mmerttccolakk/akilli-rgb-led-denetleyici-terminal/c#-bilgisayar/AkilliAmbiyansRGBLED/AkilliAmbiyansRGBLED/Resources/ambilight-capture-screen-edge-colour.jpg

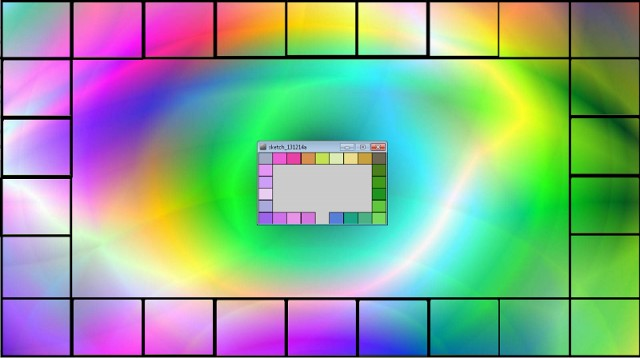
c#-bilgisayar/AkilliAmbiyansRGBLED/AkilliAmbiyansRGBLED/Resources/ambilight-capture-screen-edge-colour.jpg
