mmerttccolakk/akilli-rgb-led-denetleyici-terminal/README.md

# akilli-rgb-led-denetleyici-terminal
Hem yazılımsal hem donanımsal bir projedir. Ws218b ledleri chipten kontrol edilir. Bilgisayar yazılımı sayesinde çeşitli modlar ile kullanılabilir. Sabit renk seçme, ses analizi ile müzik şiddetine göre renklendirme, görüntü işleme ile ambiyans yaratma, polis, itfaye, flash, alarm gibi çeşitli modlar vb.
