mmerttccolakk/akilli-rgb-led-denetleyici-terminal/bitirme-proje.pdf

T.C.

## KARABÜK ÜNİVERSİTESİ

## MÜHENDİSLİK FAKÜLTESİ

## MEKATRONİK MÜHENDİSLİĞİ

## AKILLI ORTAM DENETLEYİCİ RGB LED

## TERMİNAL

# BİTİRME TEZİ

Hazırlayan

MERT ÇOLAK | 2015110226006

Tez Danışmanı

Yrd.Doç.Dr. İbrahim ÇAYIROĞLU

KARABÜK-2019

İÇİNDEKİLER

Sayfa
İÇİNDEKİLER | 1
ÖNSÖZ | 3
ÖZET | 4
TABLOLAR VE ŞEKİLLER | 5
KISALTMALAR | 6
BÖLÜM 1 | 7
GİRİŞ | 7
1.1. GİRİŞ | 7
1.2. AMAÇ | 7
1.3. KULLANIM ALANI | 7
BÖLÜM 2 | 8
ELEKTRONİK KART TASARIMI, ÜRETİLMESİ VE PROGRAMLANMASI | 8
2.1. KULLANILAN ENTEGRELER VE KOMPANENTLER | 8
2.1.1. ATMEGA328P-AU MİKRODENETLEYİCİ | 8
2.1.2. CH340G (USB_TTL) | 9
2.2. KART ÜRETİMİ | 9
2.2.1. ŞEMA ÇİZİMİ | 10
2.2.2. BASKI ÇİZİMİ | 11
2.2.3. BASKI DEVRE YAPMA | 11
2.3. ELEKTRONİK KARTIN PROGRAMLANMASI | 102
2.3.1. BOOTLOADER YÜKLENMESİ | 13
2.3.2. PROGRAMIN YÜKLENMESİ | 13
2.3.3. ELEKTRONİK KARTIN İLETİŞİM PROTOKOLÜ | 14
2.3.4. ELEKTRONİK KARTIN PROGRAMI | 15

### ÖNSÖZ

Öncelikle, projeme görüşleriyle yön veren ve desteğini hiç esirgemeyen, Yrd. Doç.Dr.

İbrahim ÇAYIROĞLU hocama ve lisans eğitimim boyunca bizden desteklerini

esirgemeyen bölüm hocalarıma teşekkür ederim. Tüm eğitim öğretim hayatım boyunca

benden maddi ve manevi desteklerini eksik etmeyen aileme sonsuz teşekkürlerimi sunarım.

MERT ÇOLAK

ÖZET

Yaptığım bu projede akıllı ortam denetleyici rgb led terminal yapacağım. Genel amaç oyun

ve film sektöründeki görselliği arttırmada kullanılan ambiyans aydınlatmalarla ilişkili.

Proje de tasarlanan kart ve yazılım sayesinde bilgisayardaki görüntüyü analiz ederek

monitörün arkasını aydınlatır. Bu bir monitörde olabilir, bir sinema sahnesi de. Böylelikle

ekrandaki oyunu, filmi ledlerle ekrandan, dışarı taşıyan kendinizi daha etkin bir şekilde

oyunun, filmin içindeymiş gibi hissetmenizi sağlayan bir aydınlatma uygulamasıdır. Sadece akıllı ambiyans yaratmayacak. Farklı modlarda eklenmiştir. Örnek vermek

gerekirse yazılımsal ses analizi. Yazılımsal ses analizi sayesinde bilgisayara ek bir

donanım takılmadan ses yazılımsal olarak analiz edilecek, kullanıcı müziği kulaklıkla dahi

dinlese analiz edilerek müziğin şiddetine göre tepki verir. Diğer modlardan bahsedecek

olursam flash, polis, ambulans, itfaiye, sabit renk gibi efektler eklenmiştir. uyku modu gibi

değişik modlarda eklenmiştir. Mesela 120 dakikaya programı kurduğunuzda istediğinize

göre 120 dakika sonunda tamamen kapanabilir veya 120 dakika dolmaya başladıkça yavaş

yavaş söner ve kapanır.

TABLOLAR VE ŞEKİLLER

Sayfa

Tablo 2: Arduino Uno ile bootloader yüklenirken bağlanması gereken pin bağlantıları... 13

KISALTMALAR

Volt | V
Amper | A
Red Green Blue | RGB
Universal Serial Bus | USB
Light Emitting Diode | LED
Transistor To Transistor Logic | TTL
Basic Input/Output System | BIOS
Alf Ve Vegard RISC | AVR
Pulse Width Modulation | PWM
Bıt Per Second | BPS
Frame Per Second | FPS

BÖLÜM 1

### 1.1. Giriş

Akıllı ambiyans aydınlatma, bulunduğu çevreyi veya ortamı o anki ses, müzik veya

görüntü analizi yaparak ortamı aydınlatır. Ortama göre aydınlatma yapılarak ışığın tonu,

rengi ve aydınlatma miktarı ayarlanabilir. Loş bir ortam veya aydınlık bir ortam seçilebilir.

Böylelikle ortam ambiyansını hissetmeyi güçlendirir. Bir su sahnesinde veya bir alev

sahnesinde ortam sahneye göre aydınlandığında sanki filmin içindeymişiz gibi

hissetmemizi sağlar.

### 1.2. Amaç

Bir akıllı ortam denetleyici rgb led terminal tasarlamak ve yazılımıyla birlikte tüm

bilgisayarla uyumlu çalışan bir yazılım yazarak akıllı ortam denetleyici projesi oluşturmak.

Böylelikle her bilgisayara kolayca takılabilen çevresel bir donanım aksesuarı

oluşturmaktır. Proje tasarlanırken seri üretim düşünülerek elektronik kart tasarlanmış ve

yazılımın uyumluluğu düşünülmüştür. Buna göre her bilgisayarda bulunan haberleşme için

USB kullanılmış. Yazılım ise C# ta yazılarak, çeşitli performans geliştirmeleri yapılarak

çekirdek için özel olarak performans seçenekleri eklenmiş ve kurulabilir şekilde

derlenmiştir. Böylece her kullanıcı bilgisayarı için istediği performansı seçerek rahatça

kullanabilmektedir.

### 1.3. Kullanım Alanı

Sinema, konferans, gösterimler, oyuncu etkinlikleri gibi görüntü odaklı veya müzik odaklı,

konser, parti gibi aydınlatma sağlanan her yerde kullanılabilir. Proje ambiyans yaratmak

istenen her yer de kullanılabilir. Ve farklı modlar eklendiği için mesela uyku modu,

karanlıktan korkan çocuklar için bile kullanılabilir. Belirli bir dakika sonunda aydınlatma

kesilir veya istenildiği takdir de seçeneklerden yavaş yavaş karartma seçilebilir. Onun

dışında acil bir durum için polis, itfaiye, ambulans gibi çeşitli modlar kullanılabilir.

Kısacası bir çevresel donanım olarak bilgisayara takılabileceği gibi bir gösteride akıllı

ortam aydınlatması için de kullanılabilir.

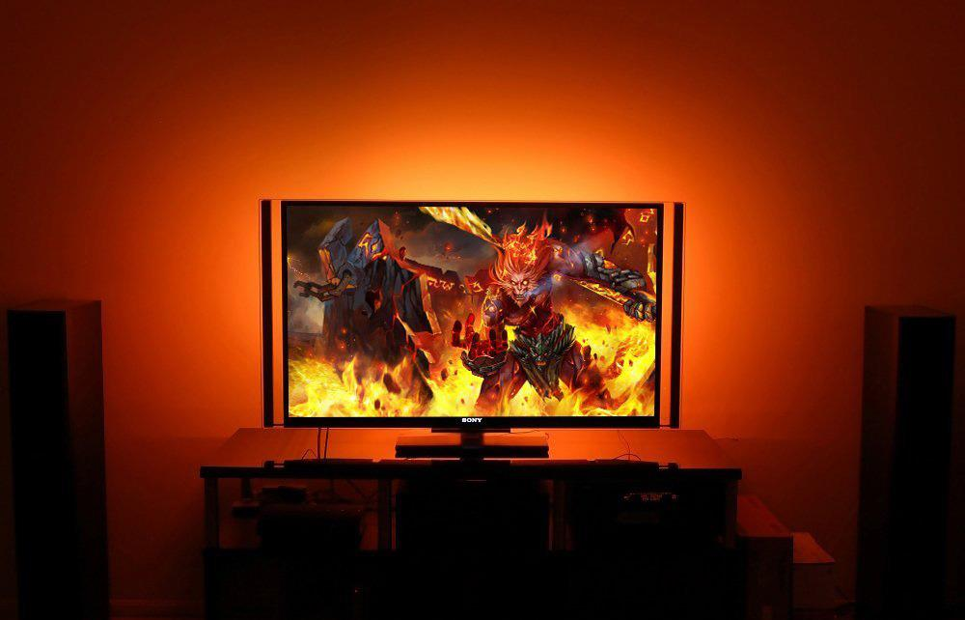
[picture p2: figure]

Şekil 1: Akıllı ortam denetleyici rgb LED terminal ile aydınlatılmış bir sahne

BÖLÜM 2

### 2.1. Kullanılan Entegreler Ve Kompanentler

Kart tasarımında iki ana entegre bulunmaktadır. Bunlardan biri “atmega328p-au” mikro

denetleyicisi. Diğeri ise “CH340G” entegresidir. Diğer kompanentler ise güç girişi için

adaptör jak’ı, voltaj regülesi için regülatör, kısa devre ve güç dalgamanlasını önlemek için

diyot ve kondansatörler bulunmaktadır.

### 2.1.1. Atmega328p-Au Mikro Denetleyici

Projenin kart üzerinde çalışan sistemin ana bölümüdür. “CH340G” gelen seri bilgileri işler

ve programlanabilir olan “WS2812B” ledlerin konumunu belirler ve ona göre parlaklık,

renk gibi verileri gönderir. Bu mikro denetleyici ürünü TQFP-32 kılıfta olup SMD yapısına

sahip olduğu için dip kılıflara göre az yer kaplar. 20 MHz frekansı ile çalışan 8 bit değerinde mikro denetleyici çeşitlerindendir. Üzerinde bulunan 32 pinin 23 adedi I/O yani

Giriş Çıkış pinidir. Bellek tipi FLASH olan bu mikro denetleyiciler 5.5V ile 1.8V besleme

aralığında, -40 C° ile +85 C° sıcaklıkları aralığında çalışabilmektedir.

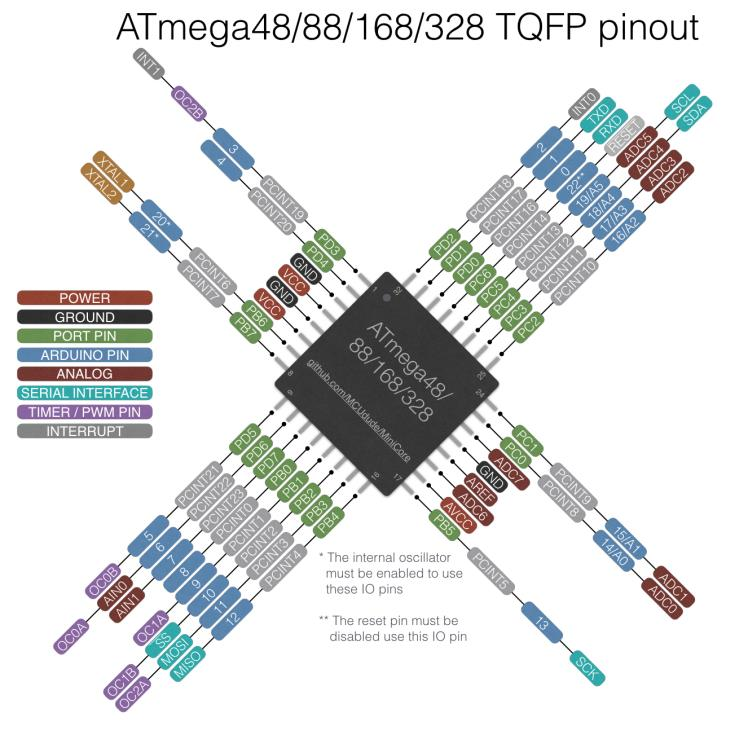
[picture p3: figure]

Şekil 2: Atmega328p-au pin yapısı

### 2.1.2. CH340G (USB_TTL)

Mikro denetleyicilerin birçoğu direk olarak USB protokolünü desteklemez. Bu entegre

yardımıyla USB protokolü ile bilgisayara bağlanarak, seri port çıkışı sağlarız. Böylelikle

seri porttan aldığımız bilgileri mikro denetleyiciye gönderebilir veya programlayabiliriz.

### 2.2. Kart Üretimi

Kart üretiminde, devremizi önce şema halinde çizeceğiz ardından baskı için baskı devresini

çizip en son da kart basımından sonra bootloader yükleyip, programlayacağız.

### 2.2.1. Şema Çizimi

Şema çizimini yaparken mikro denetleyicinin ve kullanacağım seri port entegresinin

datasheet’ini kullanacağım. Daha önceden kullandığım kart tasarlarımdan da örnek alarak

şemayı parça parça modül olarak tasarlayacağım. Böylelikle ilk devremizi test ederken tek bir kart tasarlamak yerine, iki ayrı modülle test edebileceğiz. Örnek olarak 2 kart

tasarlanacak ve bir sorun olursa tüm entegreler tüm çizimler yeniden çizilmeyecektir. En

son devreler sorunsuz çalışır ise tek bir kart tasarlanarak tekrar basılacaktır. Buradaki amaç

aslında versiyon geliştirmek içinde kullanılabilmektedir. USB-TTL modülü sabitse diğer

versiyonda mikro denetleyici değişirse prototipini test etmek hem daha ekonomik hem de

daha hızlı olacaktır. Buradaki tasarladığım devrede bir sorun çıkmadı. Usb-ttl ve mikro

denetleyici olarak tasarladığım iki modülde düzgün çalıştı. Böylelikle tek bir kart tasarımı

yaparak projeyi bitirdim.

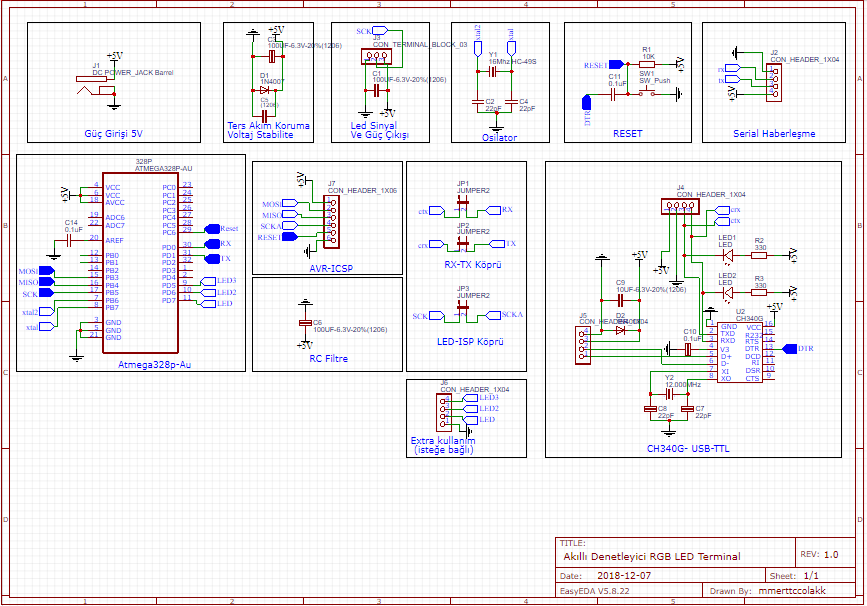
[picture p4: figure]

Şekil 3: Şema Tasarımı

### 2.2.2 Baskı Çizimi

Şemasını çizdiğimiz elektronik kartın, baskı devresi için devre yollarını çizdim bu

bölümde. Burada dikkat edilmesi gereken nokta dip ve smd elemanlarını yerleştirirken

yüzlere dikkat edilmesidir. Dip kompanentler olduğu zaman kartın diğer yüzünde olduğu

için entegreler simetri edilerek karta çizilir. Bir diğer noktada elemanların güç analizini

yaparak mesela devremizde olan güç çekecek olan “şerit programlanabilir ws218b ledleri”

gibi elemanların devre yollarını kalın tasarlamaktır.

Link 1: Elektronik Kart Şeması Ve Baskı Devresi

“https://easyeda.com/mmerttccolakk/Amblight-Project”

Bağlantı Yolu Genişliği | Taşınabilecek Maksimum Akım Değeri
0,2 mm | 100 mA
0,5 mm | 300 mA
1,0 mm | 2,5 A
2,0 mm | 5 A
3,0 mm | 6 A
4,0 mm | 7 A
5,0 mm | 9 A

Tablo 1: Baskı devre yolları tasarlanırken standart bir bakır plaka için kompanentlerin ve

elemanların çekebileceği amper göz önüne alınarak devre yolunun genişliğine dikkat

edilir.

### 2.2.2 Baskı Devre Yapma

Baskı devre yapmak için birçok yöntem vardır. Seri üretim için cnc veya lazerli bakır yol

çiziciler vb. Ben baskı devreyi yaparken ütü baskı yöntemini kullandım. Baskı devreyi çizdiğim baskıyı aynalayarak pdf’i lazerli yazıcıyla kuşe kâğıdına çıktı aldım.

Aynalamamın sebebi kâğıttan bakır yüzeye geçtiğinde çıktının simetrisi olmaktadır.

Burada yazıcının tonerli olması önemli çünkü toner sıcaklıkla transfer olabilen bir madde.

Ve biz bu maddeyi ütülerek baskı devreye geçiriyoruz. Bakır levhayı temizledikten sonra

ütünün en sıcak ayarında çıktı aldığımız kâğıdı 10 dakika ütülüyoruz. Baskı devre, bakır

plakaya çıktıktan sonra. Bakır levha üzerindeki kâğıdı su ile yavaşça temizliyoruz, sadece

toner kalacak şekilde. Daha sonra %20 Pehidrol, %80 Tuz Ruhu karışımına atarak bakır

levhanın tonerli olmayan kısımlarının erimesini bekliyoruz. Yaklaşık 5 dakika sürüyor.

Böylelikle devre yollarımız çıkmış oldu. Ardından pin deliklerini delerek, kompanentleri

yerleştirip lehimliyoruz.

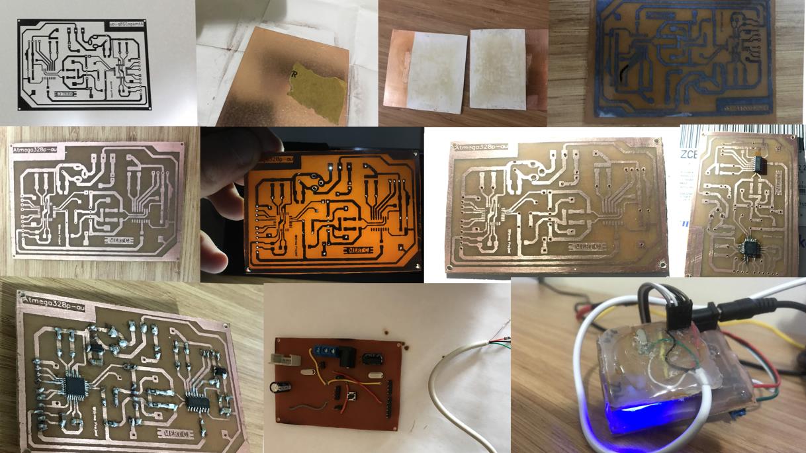
[picture p5: figure]

Şekil 4: Baskı Devre Yapma

### 2.3. ELEKTRONİK KARTIN PROGRAMLANMASI

Öncelikle kullandığımız mikro denetleyici (atmega328p-au) ATMEL altyapısında olduğu

için ilk çalıştırma için bootloader gereklidir. İlk çalıştırma için bu zorunlu bir işlemdir.

Bootloader işlemi tıpkı bilgisayarların BIOS’u gibi düşünülebilir. Mikro denetleyicinin

temel fonksiyonlarını yerine getirmesi için gereklidir. Bootloader işlemi ISP protokolü ile

başka bir ATMEL mikro denetleyici veya bir AVR programlayıcısıyla gerçekleştirilebilir.

Ben | bir | arduino | kullanarak | bu | işlemi | gerçekleştirdim. | Bootloader | işlemini

gerçekleştirdikten sonra artık ttl seviye ile devremizde bulunan “CH340G” entegremiz

sayesinde bir daha programlayıcı gerekmeden devre kendisini USB protokolünü kullanarak

programlayabilecektir.

### 2.3.1. BOOTLOADER YÜKLENMESİ

Öncelikle arduino veya avr bağlantımızı şekil 5 te verilen şekilde ISP pin ve güç

bağlantılarını yaptıktan sonra Arduino Programını IDE sini açıyoruz.

- Dosya > Uygulamalar > ArduinoISP seçip.
- Araçlar > Board > Arduino Uno
- Araçlar > Serial Port (Burdan hangi Com portundaysanız onu seçin)
- Araçlar > Programlayıcı > AVRISP mkII seçiniz.
- Araçlar > Önyükleyiciyi yazdır.

Böylelikle Bootloader işlemini tamamlamış olduk.

ARDUİNO UNO | MİKRODENETLEYİCİ
5V | VCC
GND | GND
10 | RESET
11 | MOSI
12 | MISO
13 | SCK

Tablo 2: Arduino Uno ile bootloader yüklenirken bağlanması gereken pin bağlantıları

### 2.3.2. PROGRAMIN YÜKLENMESİ

Kartımıza daha önceden yerleştirdiğimiz dahili olan “CH340G” entegresi olduğundan

dolayı kartımıza Arduino IDE’yi açarak kolayca arduino uno programlıyormuş gibi

programlayabiliriz. Kartımızı USB ile bilgisayarımıza taktığımızda “CH340G” entegresi

RX-TX bağlantıları ile atmega328p-au ile veri transferi yaparken DTR-RESET bağlantısı

ile de otomatik yazılım yükleme moduna almaktadır. Yazdığımız kodu kartımıza atmak için programımızı açtıktan sonra, Araçlar > Kart menüsünden Arduino UNO seçeneğini

tıklıyoruz. Daha sonra, yine Araçlar menüsünden Port alt menüsü altında kartımızın bağlı

olduğu portu seçiyoruz. Bu port numarası, her bilgisayarda farklı olabilmektedir.

Programımızı yazdıktan sonra kartımıza yüklemek istediğimizde, öncelikle “Kontrol Et”

seçeneğine tıklıyoruz. Program, yazdığımız kodu öncelikle bilgisayarımızda bir klasöre

kaydetmemizi istiyor, daha sonra da yazdığımız kodu derleyerek herhangi bir hata varsa bu

hatayı bize bildiriyor. Eğer yazdığımız kodda bir hata yoksa ve kartımız bilgisayarımıza

USB ile bağlıysa, “Yükle” seçeceğine tıklayarak kodumuzu kartımıza yükleyebiliyoruz.

### 2.3.3. ELEKTRONİK KARTIN İLETİŞİM PROTOKOLÜ

Elektronik kartın iletişimi “CH340G” entegresi ile bilgisayardan usb bağlantısıyla seri port

açıp atmega328p-au bağlanmasıyla gerçekleşir. Elektronik kartın programı yazılırken veri

iletişim performansını ve yazılımın stabilitesini arttırmak amacıyla değişkenler minumum

seviyede kullanılmış. Ve üst değer limitleri fazla olan int long vs değişkenleri mümkün

olduğu yerlerde byte ve sabit değer yapısıyla tasarlanmıştır. Int ile 0-255 saydırmakla byte

yapısında 0-255 saydırmak arasında performans açısından büyük bir fark bulunmaktadır. 1

Byte = 8 Bit değerindedir. Kısaca programın iletişim protokolünden bahsedecek olursam.

60 Led’imiz varsa her biri için 3 byte gereklidir. Her byte led’in bir rengi için bir PWM

değerini temsil etmektedir. Bir led’te tüm renkleri oluşturabilmek adına 3 ana renk

bulunur. Bunlar kırmızı, yeşil ve mavidir. Bunlara ayrı, ayrı vereceğimiz pwm sinyali

sayesinde bir led’te 0-255^3 ten 16581375 farklı renk elde edilebilmektedir. Ledlerin

konumu için ise farklı bir protokol geliştirerek konum bilgisi göndermedim. Eğer konum

bilgisini de göndersemdim 3 byte yerine her seferinde 4 byte gönderecektim ve buda %25

performans kaybı demektir. Bilgisayar programında kaç adet led’imiz olduğunu kurulum

sırasında bir kez söylüyoruz. Ve daha sonra her iki program her 3 byte da bir diğer led için

bilgileri almaya başlıyor. Bu döngü her led için tekrarlandıktan sonra program başa

dönüyor. Böylece 3 byte ile hem konum hem de renk bilgisi sağlanabiliyor. Programımız

115200 BPS de iletişim kuruyor. Saniyede 115200 bit transfer ediliyor.

Bir saniyede tüm led’lerin güncellenme sayısı:

60 led’imiz olduğuna göre 60*3 RGB için 180 byte

60*3*8 byte >> bit çevrimi 1440 bit
İletişim protokolümüz bant genişliği 155200 bps

Saniye tüm ledlerin güncellenme sayısı 115200/1440=80 rps

Kısaca iletişim protokolümüz 60 tane rgb led’i konumuna ve rengine göre saniyede 80 defa

güncelleyebiliyor.

### 2.3.4. ELEKTRONİK KARTIN PROGRAMI

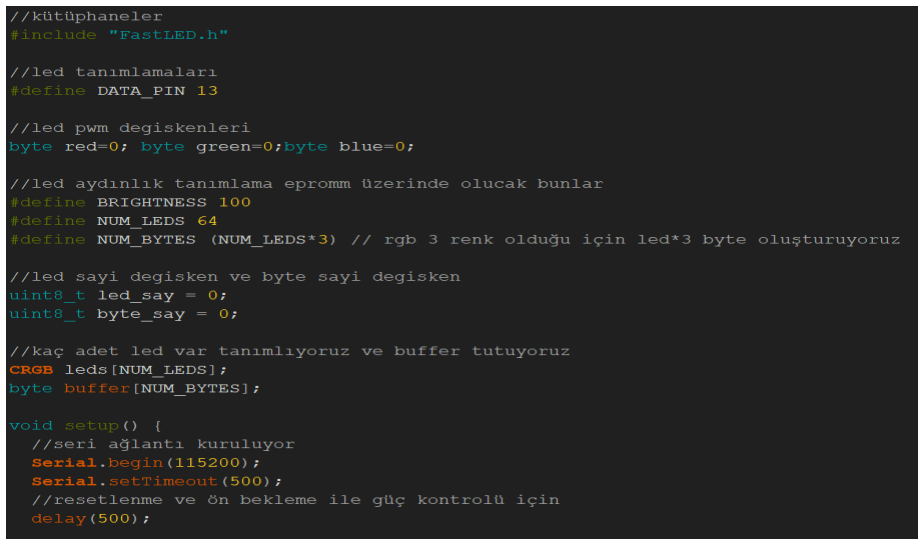
[picture p6: figure]

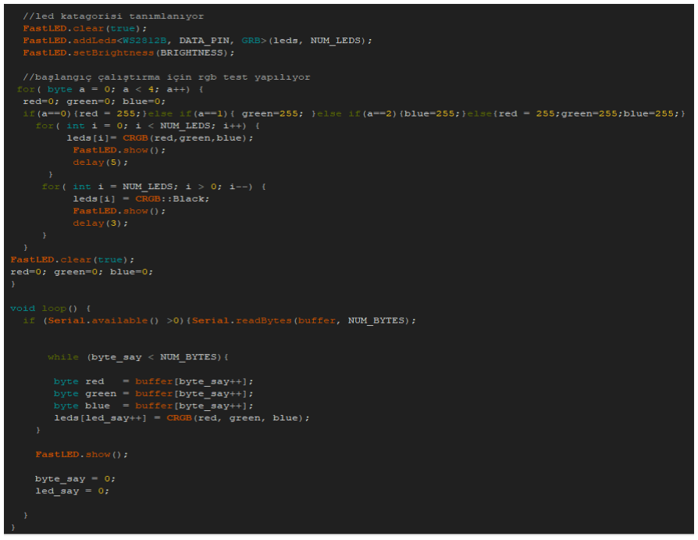
[picture p7: figure]

Şekil 5: Elektronik Kartın Program Kodları

BÖLÜM 3

### 3.1. LCD ÇERÇEVE YAPIMI

LCD çerçeve yaparken, tasarlayacağımız çerçeve programlanabilir olan WS218B şerit

ledlerden yapılmıştır. Kolaylıkla çerçevenin her bilgisayarın monitörüne, televizyona,

sinema sahnesi vs uyumlu olması için modüler yapılmıştır. Ekleme aparatlarıyla sadece

ledleri keserek araya 90 derece konektörler atılır.

### 3.1.1. LCD ÇERÇEVESİ MONTAJI

Ledler, ekranın ölçüsü alınarak yatayda ve dikeyde uygun boyda kesilir. Ardından 90

derecelik konektörler takılarak dikdörtgen biçimine getirilir. Burada dikkat edilmesi

gereken nokta ledlerin akış yönüdür. Ledler üzerindeki oklara göre birbirine bağlanmalıdır.

Çerçeve dizildikten sonra sıcak silikon ile bilgisayarın çerçevesine montajı yapılmıştır.

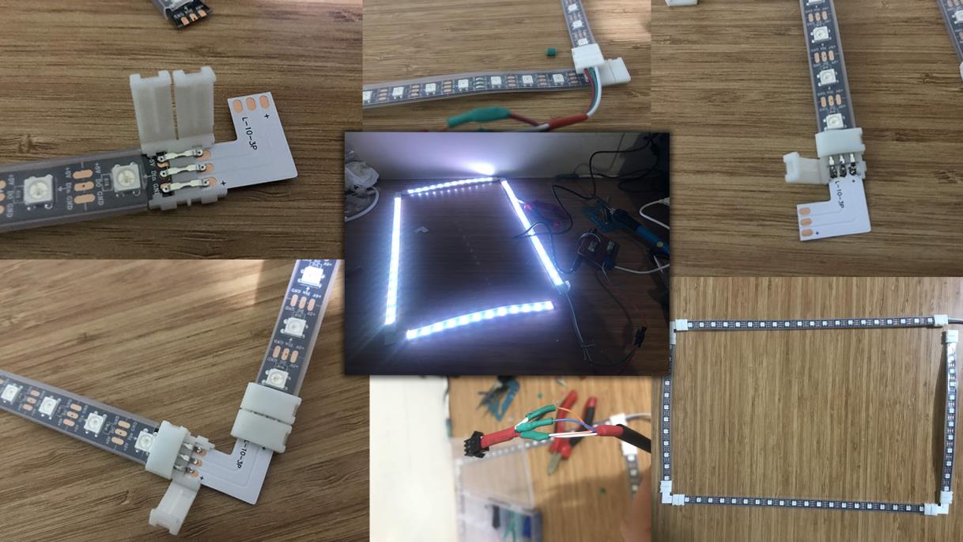
[picture p8: figure]

Şekil 6: LED çerçevenin yapımı

### 3.1.2. LED İÇİN JAK VE KABLO BAĞLANTISI

LCD çerçevesi tamamlandıktan sonra sıra LCD çerçevesinin elektronik karta

bağlanmasında, bilgisayara sürekli olarak takılmayacağını düşünürsek veya taşınabilir bir

bilgisayara takılabileceğini düşünürsek bu çerçeveye sabit bir kablo takmak doğru olmaz.

Konektör tarzında kablo ayıraçları ile kablolar takılmıştır. Bir konektör LCD çerçeveye

bağlanırken Bir çerçevede elektronik karta bağlanarak istenildiğinde bilgisayardan kart

sökülüp başka bir bilgisayara takılabilir. Ve taşıma aşamasında kolaylıkta sağlar. Kablo

konektörleri bağlanırken lehim kullanılarak zamanla oksitlenmesi engellendi daha sonra

kablolar makaronla sarılıp ısıtıldı ve iyice sağlamlaştırıldı.

BÖLÜM 4

### 4.1. BİLGİSAYAR PROGRAMI

Bilgisayar programı Visual Studio programında C# programlama dili kullanılarak

yazılmıştır. Kullanıcıların kolaylıkla kullanabilmesi için arayüz sadeleştirilmiş, ayarlar ve

hesaplamalar otomatikleştirilmiştir. Program ilk açıldığında led sayılarını bir kez girip

kaydet’e basmanız durumunda bir daha tekrar aynı ayarı yapmanıza gerek kalmamaktadır.

Program içerinde özel ayarları tutan bir veri tabanı eklenmiştir. Ayrıca her bilgisayarda

kolaylıkla çalışabilmesi için RAM ihtiyacını düşük tutan (using, thread, private value gibi)

fonksiyonlarla programlanmıştır. Programı ilk tasarladığımda saniyede iki kere görüntü

analizi yaparken fonksiyon kullanımlarını ve çeşitli performans ayarlarını öğrendiğimde bu

sayı saniyede dört yüz ’ün üzerine çıktı. RAM ise 1500MB tan 30MB düştü. Burada

belirtmek istediğim konu iki kodda aynı işi yaparken aradaki kod farkının ne derece önemli

olduğudur.

### 4.1.1. PROGRAMIN KURULMASI

Programın kurulması ve ayarlarının yapılması için ilk önce program açılır ve LCD

çerçevenin tek taraflı boyuna ve yatay ledleri sayılarak programın sol üstteki kısmına girilir

ve “Ayarları Kaydet” butonuna tıklanır ve program yeniden başlatılır. Daha sonra bağlantı

ayarları için elektronik kart bilgisayara takılır ve “Port” kısmından COM portu seçilerek bağlana tıklanır. Eğer bilgisayarda başka bir cihaz bağlı değilse zaten tek bir port

gözükecektir. Ama birden fazla cihaz takılıysa yanlış portu seçebilirsiniz. Eğer yanlış portu

seçmiş iseniz LCD çerçeve bir tepki vermeyecektir. “Bağlantıyı Kes” deyip bir diğer portu

seçin. Eğer doğru portu seçtiyseniz çerçeve kırmızı, yeşil, mavi ve beyaz olmak üzerine

hızlıca yanıp söner. Bunun bir diğer nedeni de rgb ledlerin sağlamlık testini yapmaktır.

Böylece kurulumda tamamlanmış olur. Bağlantı portunu değiştirmediğiniz sürece port

numarası sabit kalacaktır.

### 4.1.2. PROGRAMIN TANITILMASI

Program 4 ana bölümden oluşmaktadır. Bunlar aşağıdaki “Tablo 3”te gösterilmiştir.

Bölüm | Açıklama
İstatistik-Durum | FPS değeri vb. değerlerin istatistikleri
Led Ve Ekran Ayarları | LED sayısının girildiği ayarlar
Bağlantı Ayarları | Bağlantının sağlandığı bölüm
Modlar | Modların seçildiği ve ayarlandığı bölüm

Tablo 3: Programın Ana Bölümleri

- İstatistik-Durum

Bu bölümde programın LED’leri kaç kere güncellediği FPS değerinden görülebilir.

Programın içerisine bir saat eklenmiştir ve bu saat son bir saniyede LED’lerin kaç kere

güncellendiğini tutarak FPS değerini ölçmüş olur. Bir diğer değişkende kaç dakika

kaldığıdır.

- LED Ve Ekran Ayarları

Bu bölümde programa LCD çerçevedeki yatay ve dikey LED sayıları girilerek kaydedilir.

- Bağlantı Ayarları

Bu bölümde seri port bağlantısı sağlanır. Aynı zamanda ilerde kart güncellenirse diye

programa bant genişlik ayarı da konulmuştur. Buradaki bağlantı kontrolü aynı zamanda

try/catch yapısı kullanılarak tasarlanmıştır. Ve bir timer ile sürekli bağlantı kontrol edilir.

Port birden kapanır veya hata verirse programda herhangi bir donma, takılma olmaz.

Program otomatik portu kapatır ve başlangıçtaki port seçim ekranına otomatik döner.

- Modlar

Modlar kısmında tab sekmesi kullanılarak bir grup içerisine birçok mod eklenmiştir.

Bunlar aşağıdaki “Tablo 4” te gösterilmiştir.

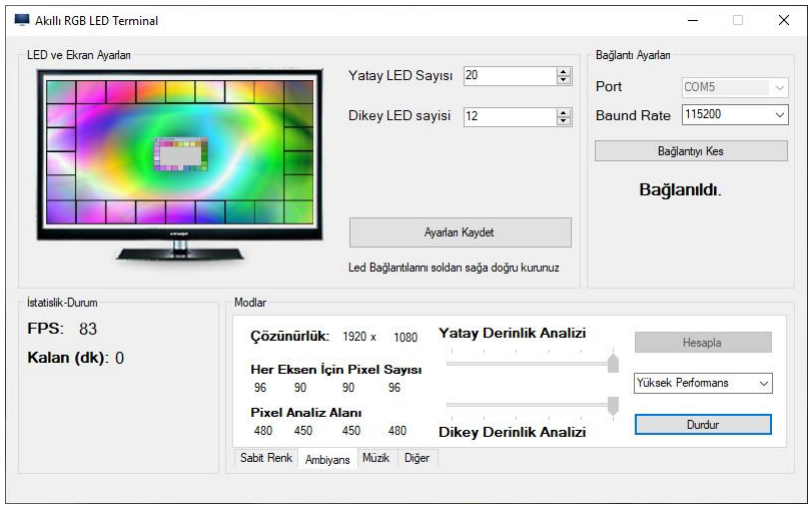
[picture p9: figure]

Şekil 7: Programdan bir görüntü

Sabit Renk Modu | Bu mod ’ta bir renk paletinden bir renk

seçilerek Tüm LED’lerin rengi değiştirilir.

Ambiyans MODU | Bu mod ‘ta yatay ve dikey analiz katsayısı

istenilirse arttırılır. Ve “Hesapla” butonuna

basarak | gerekli | hesapların | yapılması

sağlanır. Ardından istenilirse Performans

ayarı değiştirilir. Buradaki performans

ayarı, | çalışan | fonksiyona | | çekirdek

önceliğinin bir parametresidir. Yüksek

Performans, Normal, Düşük Performans

gibi parametreleri vardır. Artık “Çalıştır”

butonuna tıklayarak ambiyans modunu

aktif edebiliriz. Bu modu aktif ettiğimizde

ekrandaki görüntüyü analiz edip ona göre

dış çerçeveyi aydınlatacaktır.

Müzik Modu | Bu mod ‘ta programda öncelikle müzik

modunda hangi çıkış veya giriş cihazının

referans alınacağı aygıt listesinden seçilir.

Bu bir mikrofon veya hoparlörde olabilir.

Daha sonra istenirse trackbar dan ne kadar

yükseltileceği seçilir. Ardından performans

ayarları istenirse seçilir. Ve en son müzik

modunun | hangi | ritimde | yansıtılacağı

seçilir. Burada farklı efektler vardır.

Mesela müziğin ritmine göre şerit ledlerin

şiddeti sıralı olarak kayar veya tamamen

müziğe göre renk şiddeti oluşturur.

Diğer Modlar | Bu bölümde bir çok efekt vardır. Mesela

uyku modu programı 120 dakikaya kurup

120 dakika sonunda tamamen kapanmasını

sağla biliriz. Veya 120 dakika boyunca

yavaşça sönmesini de seçebiliriz. Onun

dışında | acil | durumlar | ve | ortam

aydınlatması için polis, itfaiye, ambulans,

flash, sakinleştirici gibi çeşitli efektlerde

eklenmiştir.

Tablo 4: Program içerisinde yer alan Modların açıklaması

### 4.1.3. PROGRAM KODLARI

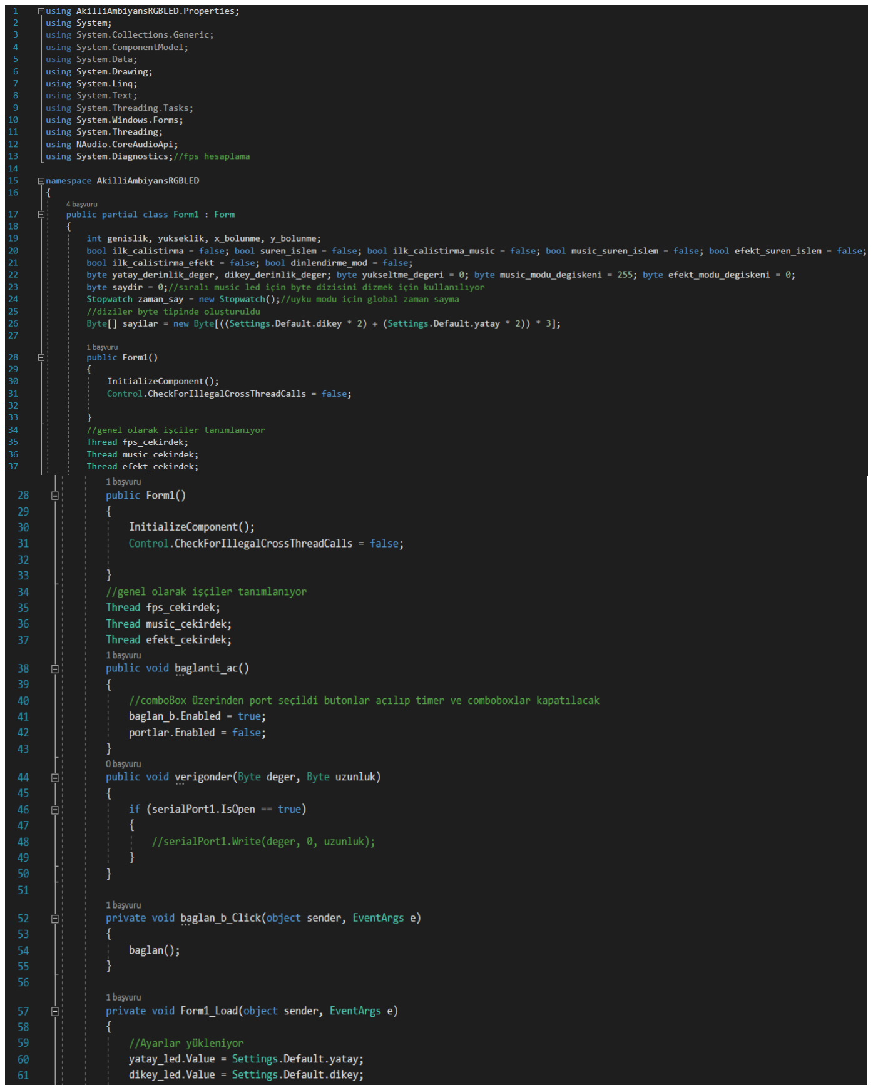
[picture p10: figure]

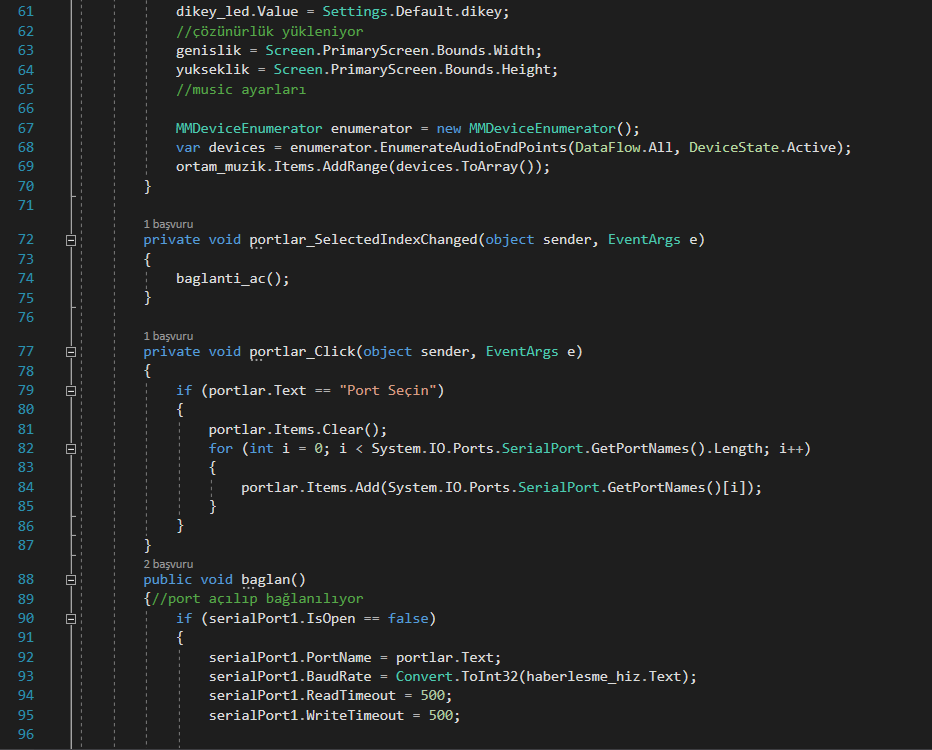
[picture p11: figure]

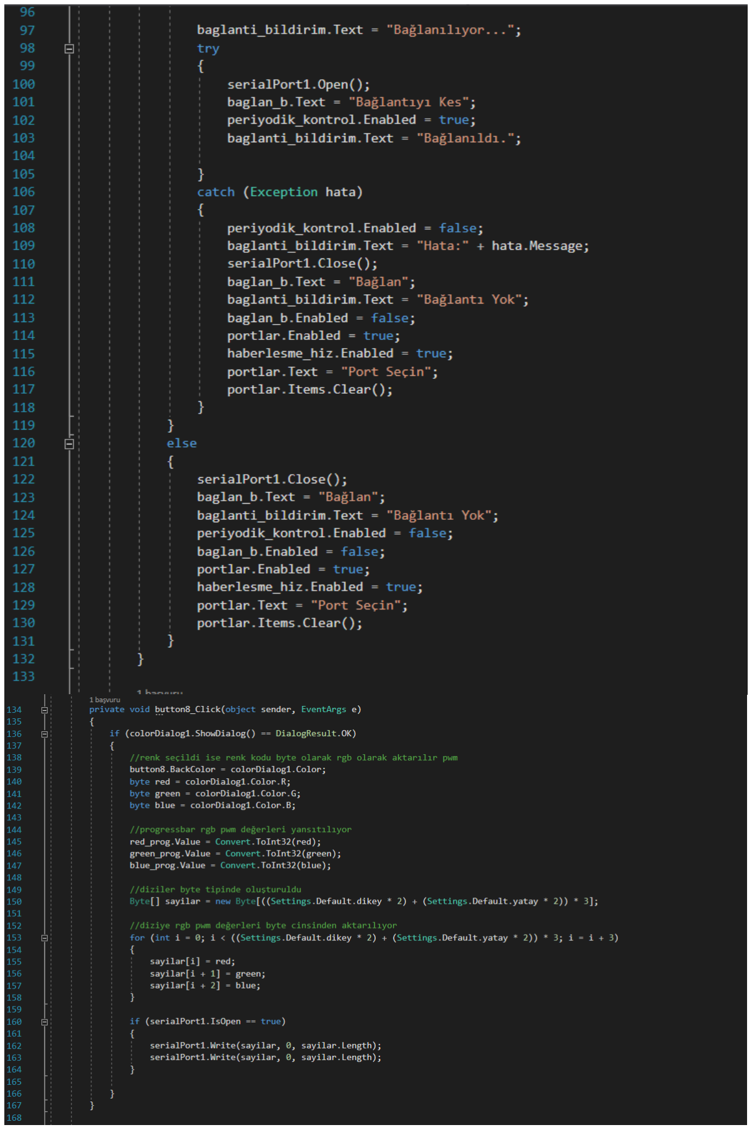
[picture p12: figure]
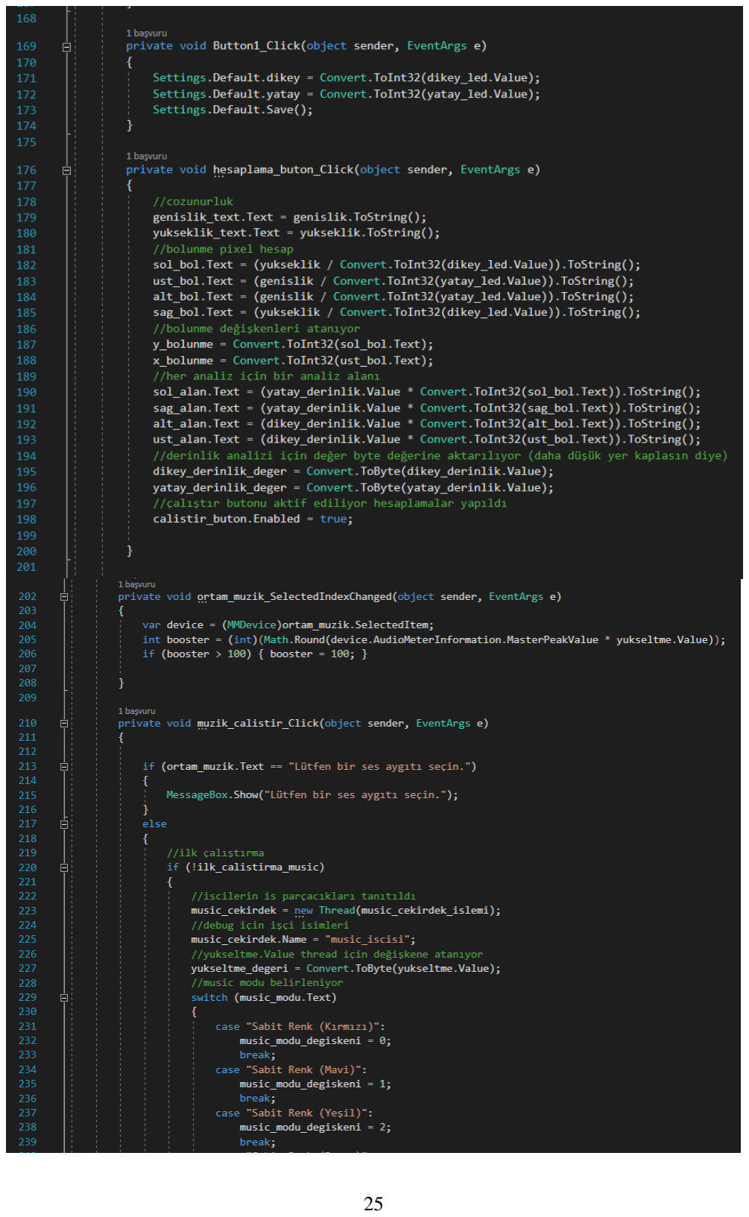
[picture p13: page 26]

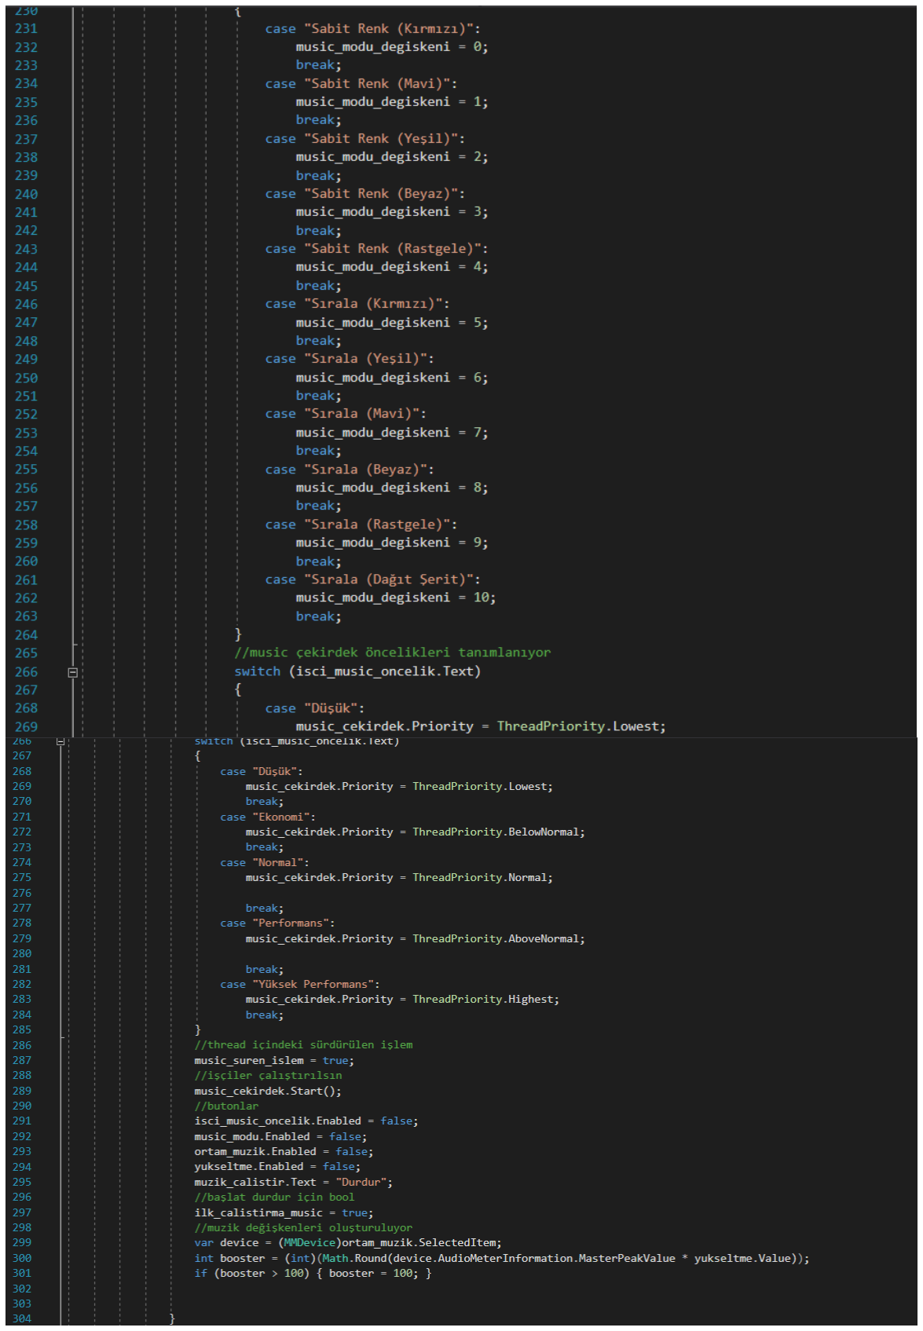
[picture p14: figure]

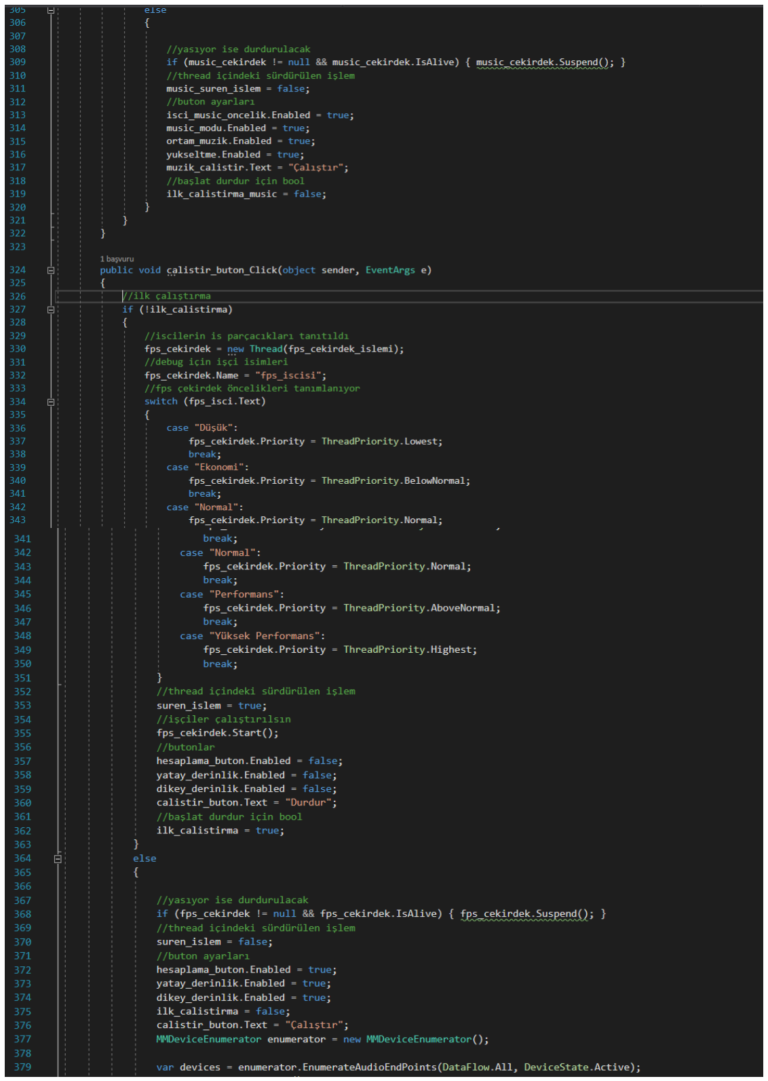
[picture p15: figure]

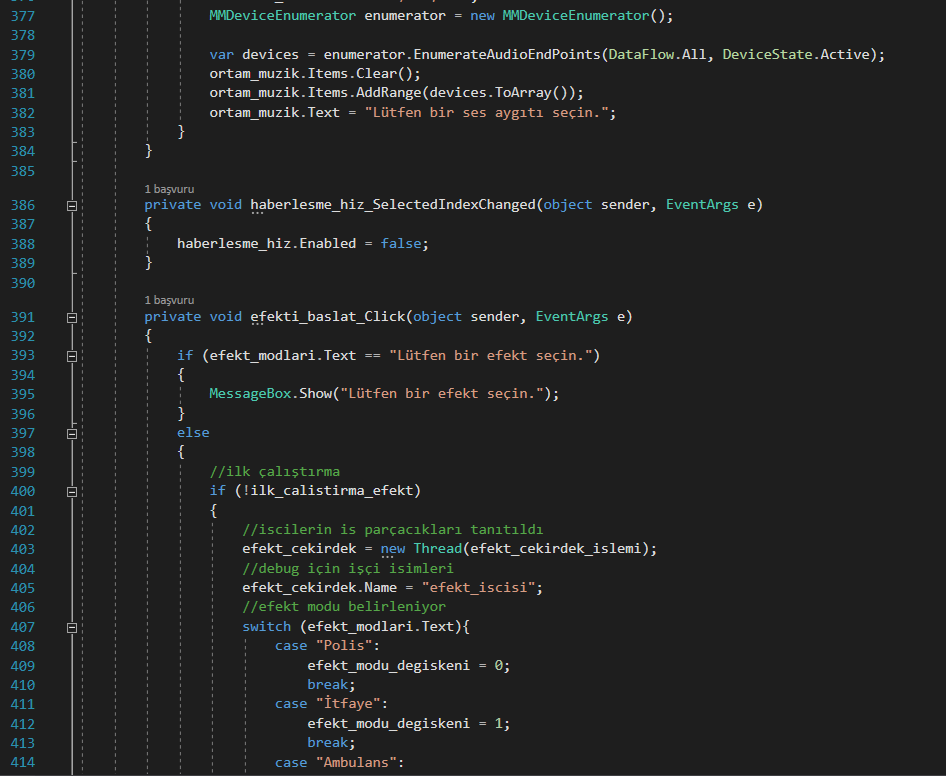
[picture p16: figure]

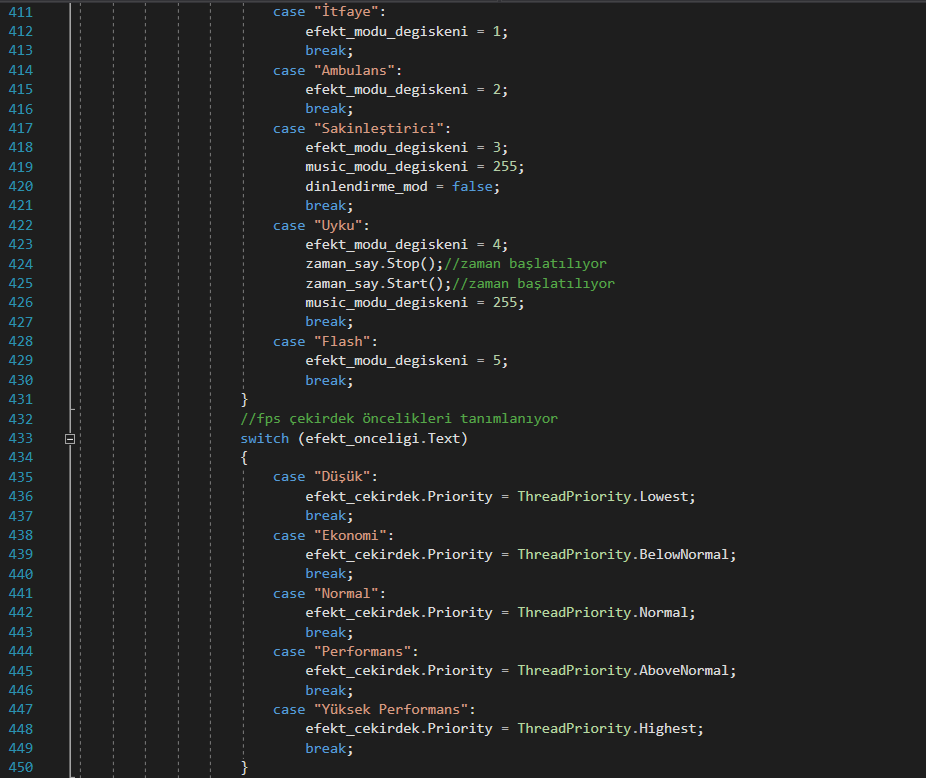
[picture p17: figure]

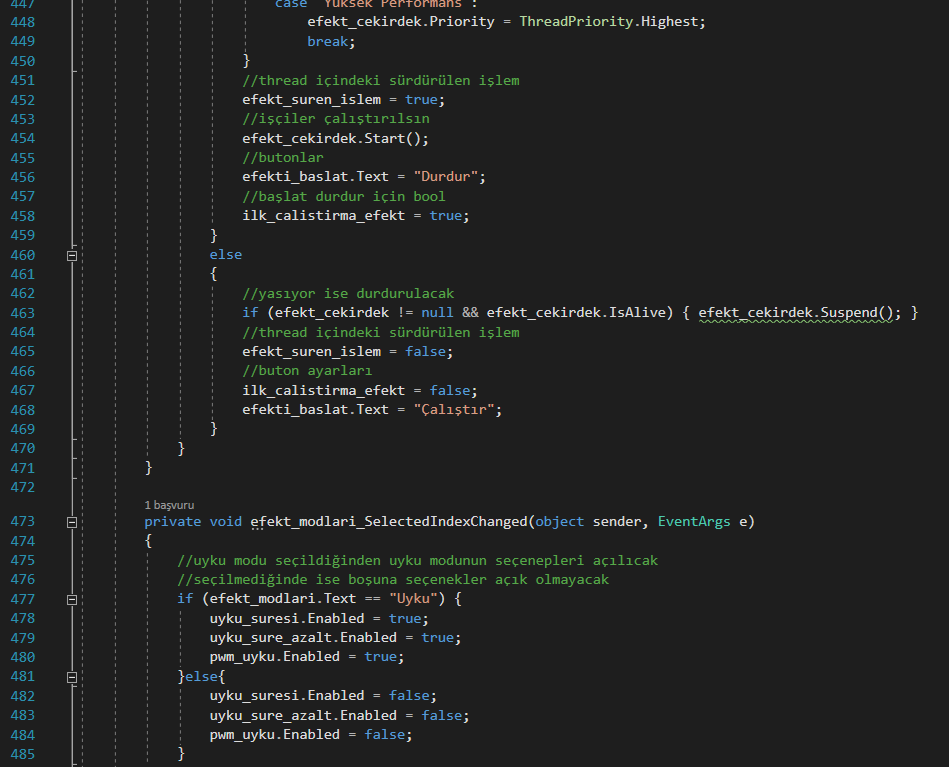
[picture p18: figure]

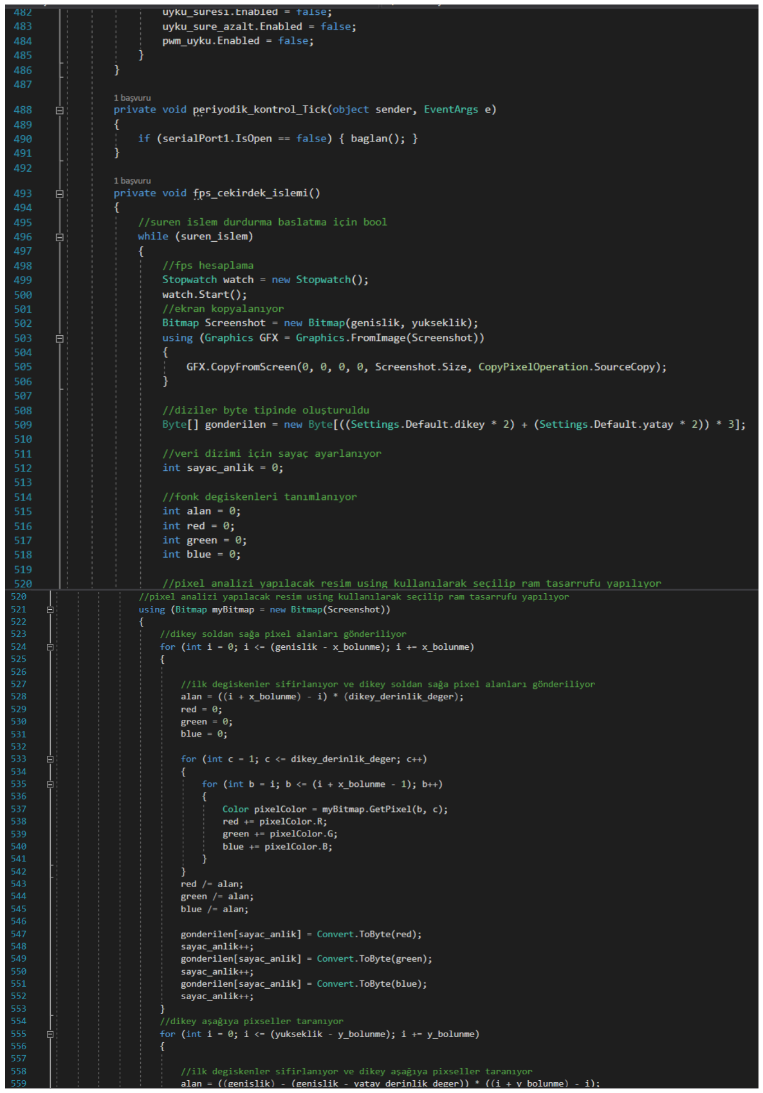
[picture p19: figure]

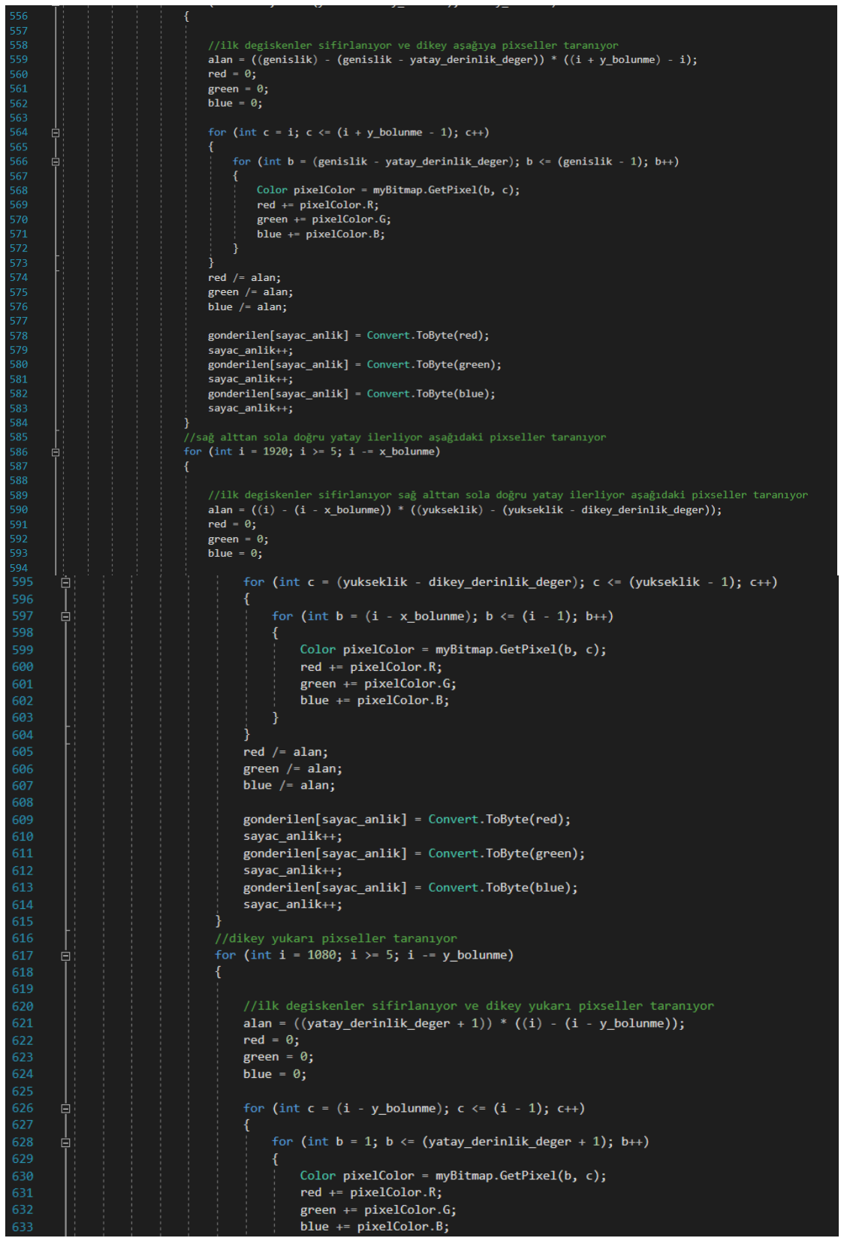
[picture p20: figure]

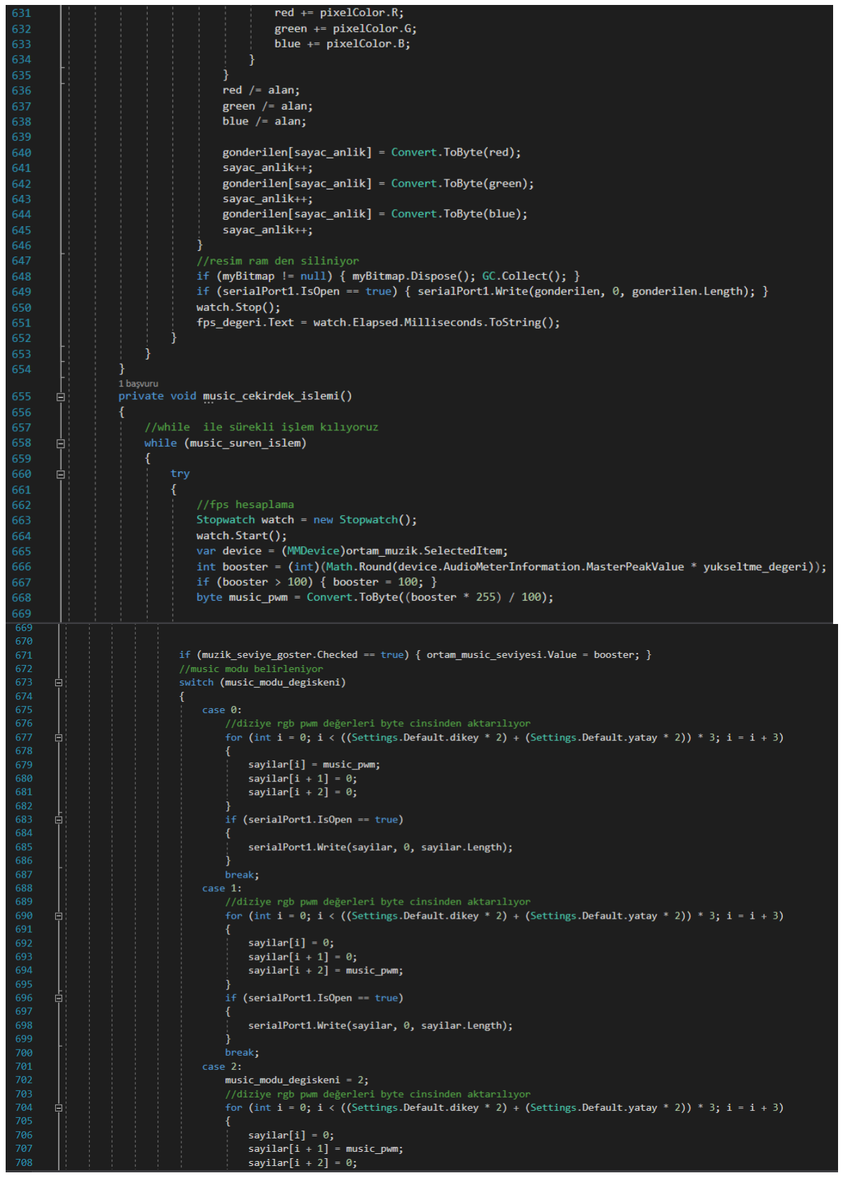
[picture p21: figure]

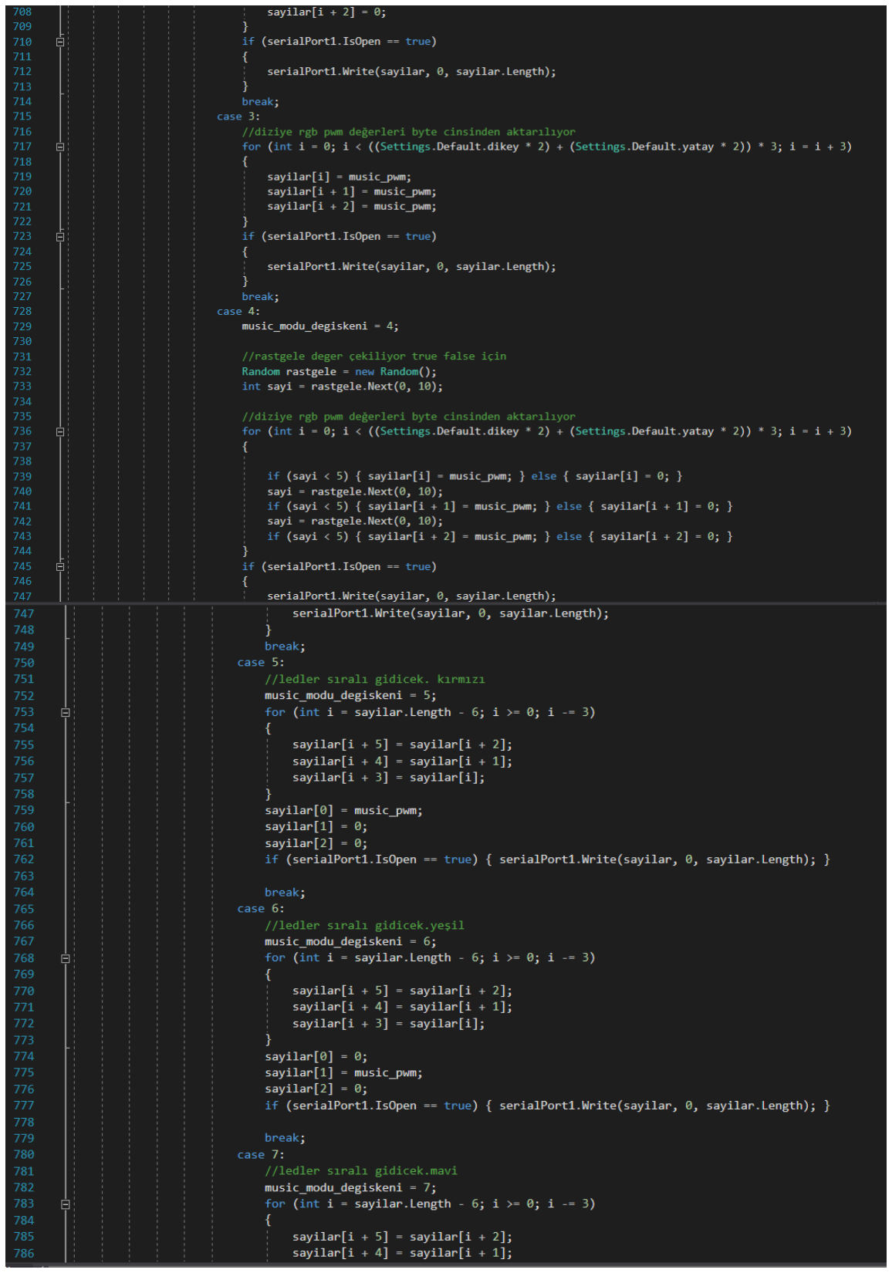
[picture p22: figure]

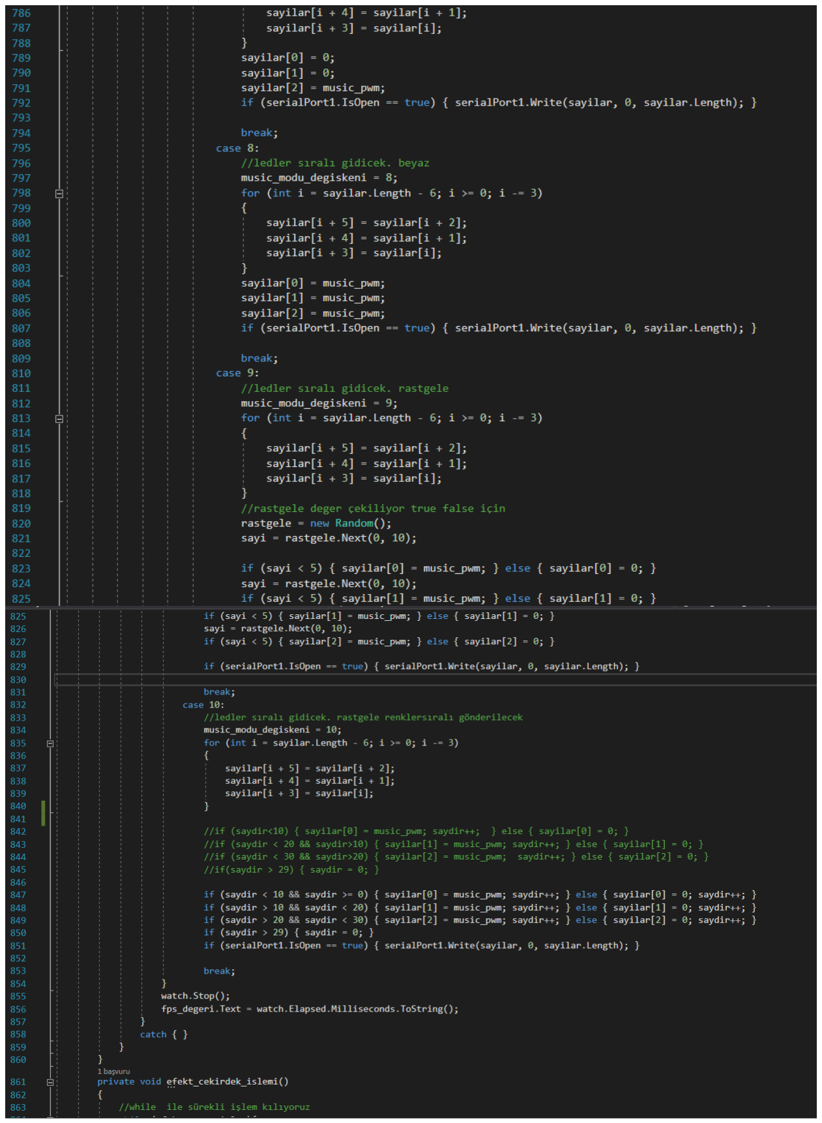
[picture p23: figure]

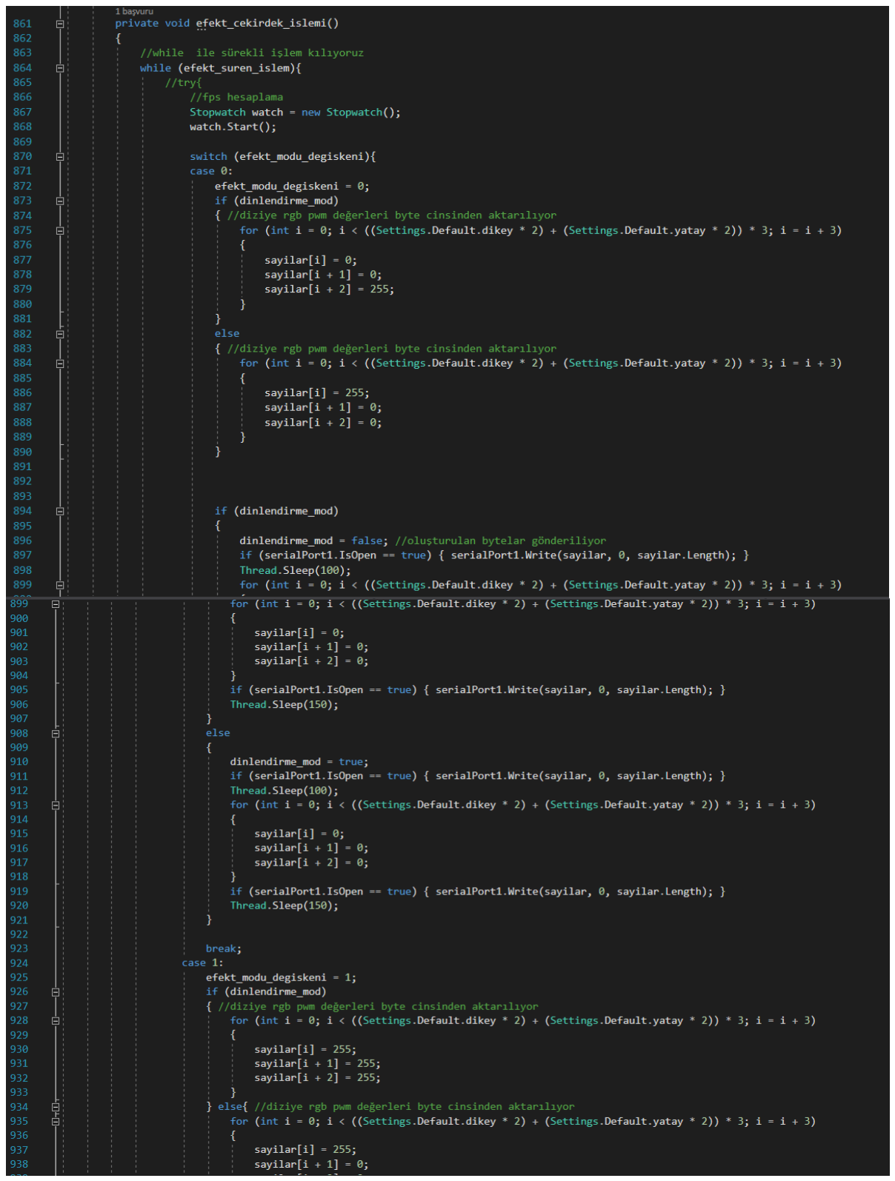
[picture p24: figure]

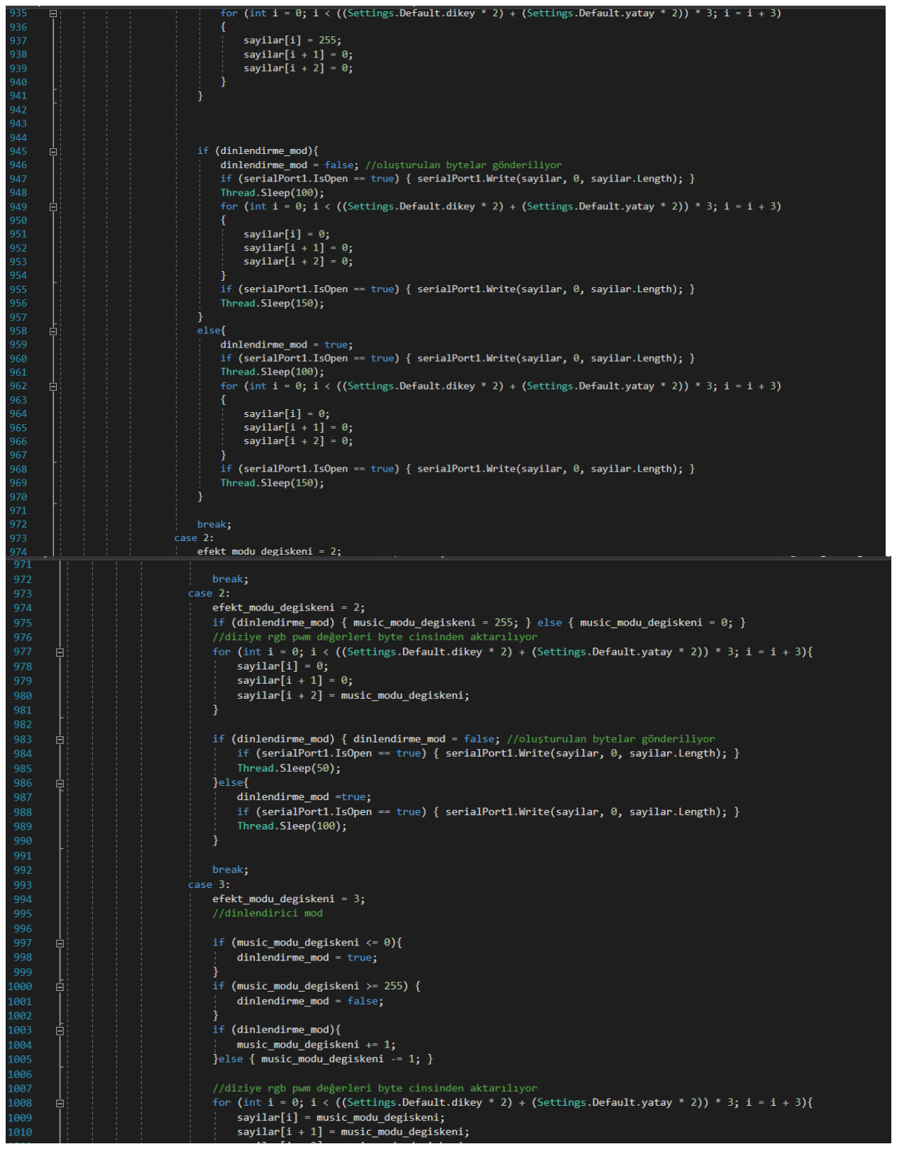
[picture p25: figure]

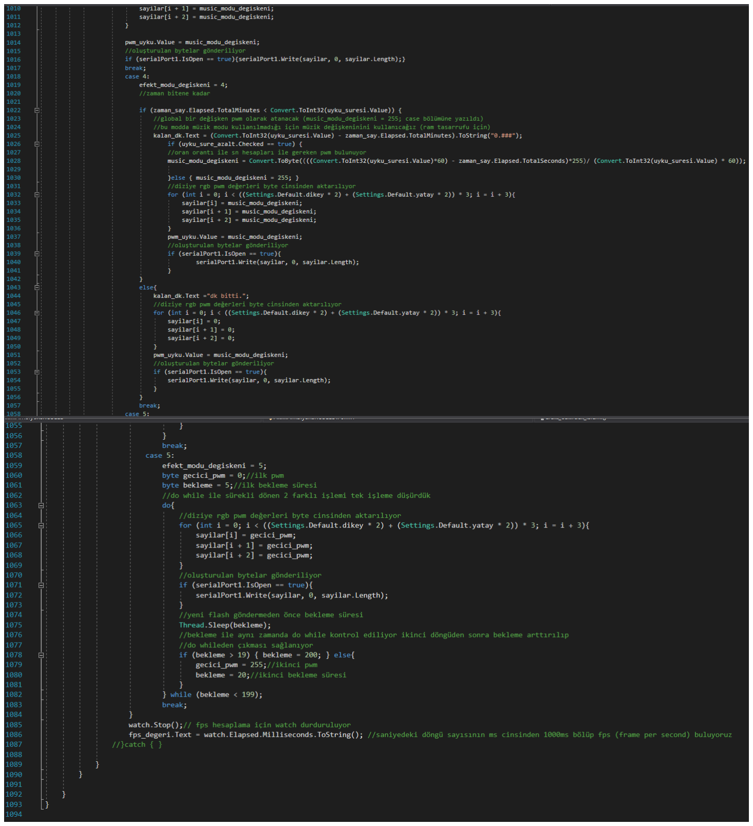
[picture p26: figure]

Link 2: Projenin çalışma videosu

“https://www.youtube.com/watch?v=wWtOZFQ5inQ”

KAYNAKÇA

[1.]https://docs.microsoft.com/en-

us/dotnet/api/system.drawing.bitmap.setpixel?view=netframework-4.7.2 (https://docs.microsoft.com/en-us/dotnet/api/system.drawing.bitmap.setpixel?view=netframework-4.7.2)

[2.]https://www.tutorialspoint.com/csharp/csharp_multithreading.htm

[3.]https://docs.microsoft.com/en-

us/dotnet/api/system.threading.thread?view=netframework-4.7.2 (https://docs.microsoft.com/en-us/dotnet/api/system.threading.thread?view=netframework-4.7.2)

[4.]https://docs.microsoft.com/en-

us/dotnet/api/system.io.ports.serialport?view=netframework-4.7.2 (https://docs.microsoft.com/en-us/dotnet/api/system.io.ports.serialport?view=netframework-4.7.2)

[5.]https://cdn.sparkfun.com/assets/c/a/8/e/4/Atmel-42735-8-bit-AVR-Microcontroller-

ATmega328-328P_Datasheet.pdf (https://cdn.sparkfun.com/assets/c/a/8/e/4/Atmel-42735-8-bit-AVR-Microcontroller-ATmega328-328P_Datasheet.pdf)

[6.]https://docs.microsoft.com/en-

us/dotnet/api/system.windows.media.color.fromrgb?view=netframework-4.7.2 (https://docs.microsoft.com/en-us/dotnet/api/system.windows.media.color.fromrgb?view=netframework-4.7.2)

[7.]https://github.com/rosterloh/ambilight

[8.]https://github.com/mpolednik/script.kodi.hue.ambilight

[9.]https://github.com/michaelficarra/ambilight

[10.] | https://cdn.sparkfun.com/datasheets/Dev/Arduino/Other/CH340DS1.PDF
[11.] | https://www.arduino.cc/en/tutorial/arduinoISP

ÖZGEÇMİŞ

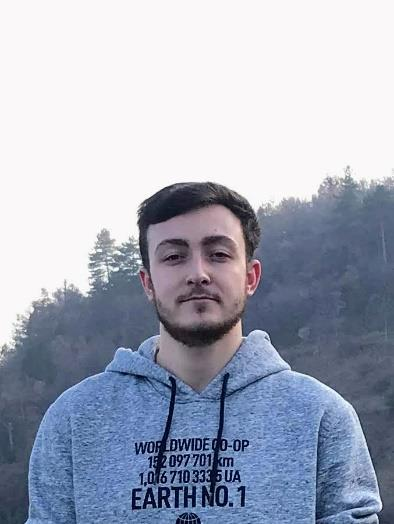
[picture p27: figure]

MERT ÇOLAK 1994'de VOLGOGRAD / RUSYA FED.'da

doğdu; ilk, orta ve lise öğrenimini K.MARAŞ / Elbistan’da tamamladı; 2015 yılında Karabük Üniversitesi Mühendislik

Fakültesi Mekatronik Mühendisliği Bölümüne girdim halende

bu bölümde eğitimime devam etmekteyim. Mekatronik

Mühendisliğinin, | kontrol | ve | yazılım | alanları | ile
ilgilenmektedir. İş disiplinine sahip, verilen görevi zamanında

yerine getiren, sosyal yönü kuvvetli, iletişim becerilerinde iyi bir kişiliğe sahiptir. İyi seviyede İngilizce bilmektedir.

İletişim Bilgileri

E-posta: | info@mertcolak.com.tr
Website: | mertcolak.com.tr

Diğer Bağlantılar:

https://github.com/mmerttccolakk

https://easyeda.com/mmerttccolakk

https://tr.linkedin.com/in/mmerttccolakk
