mmerttccolakk/akilli-rgb-led-denetleyici-terminal/sunum/3.pdf

Akıllı Ambiyans Denetleyici RGB LED Terminal

Bu hafta, kartın çıktılarını almak için kartların SVGçıktısını alarak Adobe Fireworks ile A4 olarak birleştirdim. Ardından A4 kuşe kâğıda çıktı aldım. Baskı devrenin basılacağıbakır levhaları zımpara ile temizleyerek. Kâğıtlarıkesip ütü sırasında baskının kaymasını engellemek için kesip bakır levhaya bantladım.

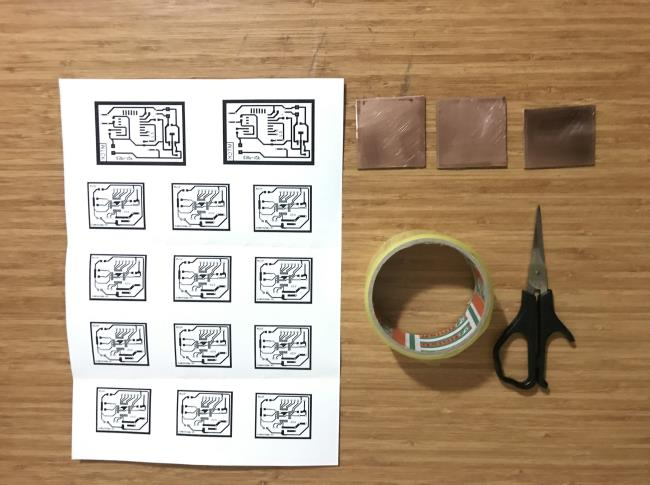
[picture p38: figure]
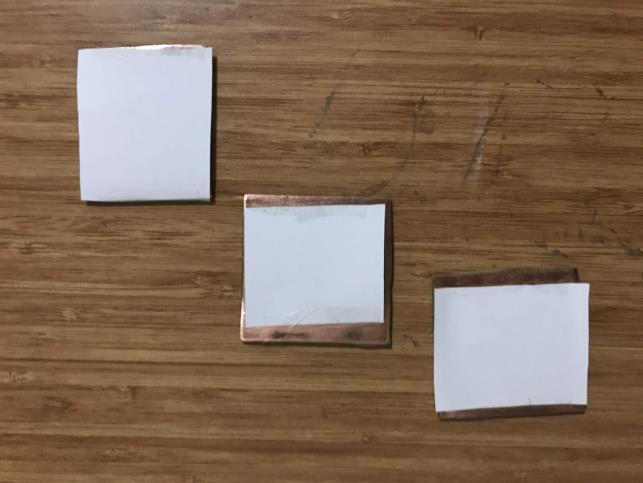
[picture p39: figure]

Baskının bakır levhaya geçmesi için 10-15dk levhaya baskı uygulayarak ütülendi. Ardından bakır levhaya geçen tonerin ortaya çıkması için bakır levhayısuya tutup kâğıtlar temizlendi.

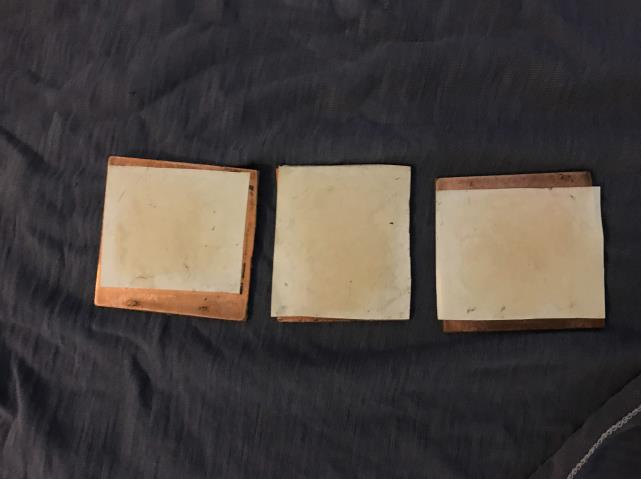
[picture p40: figure]
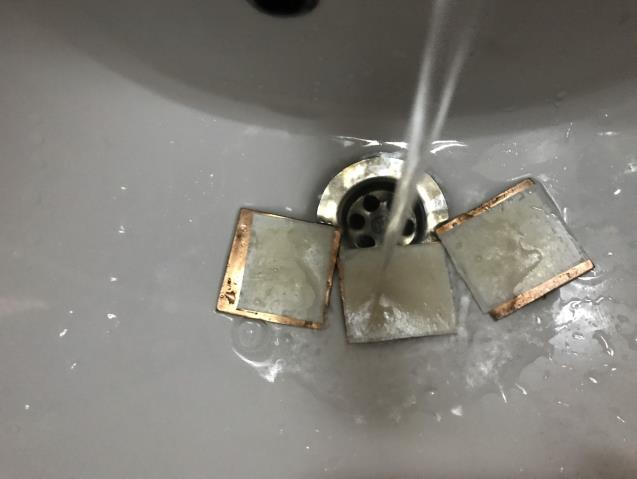
[picture p41: figure]

Kâğıtlar temizlendikten sonra pedirol/tuzruhu çözeltisine atılarak tonerin dışındaki bakır kısımlareritildi. Daha sonrasında toner ile ortaya çıkan yollar parfüm (sentetik tiner veya sentetik alkol gereklidir.) ve peçete ile silinerek bakır yüzeyinin çıkması sağlandı. Daha sonra devrelerin pin delikleri dramel ile delindi.

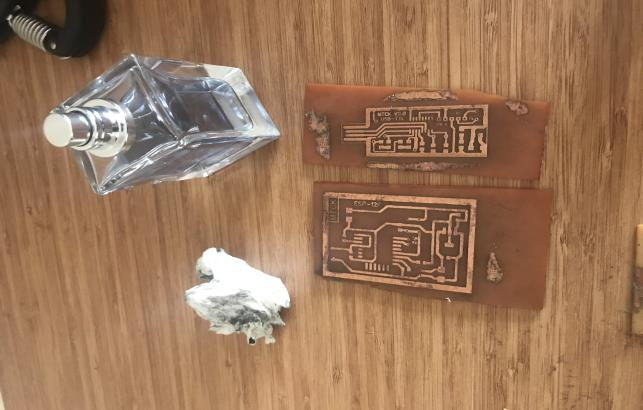
[picture p42: figure]
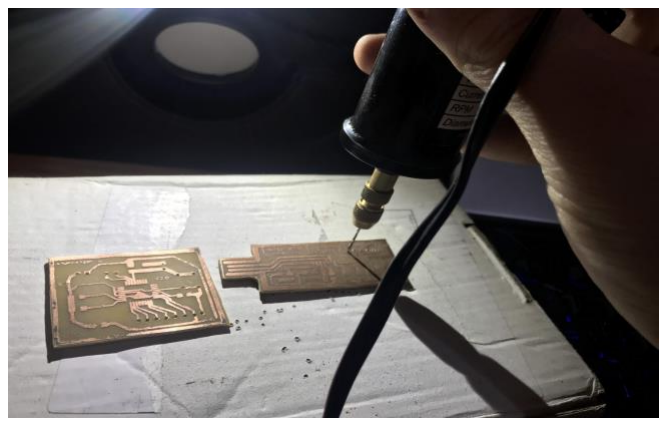
[picture p43: figure]
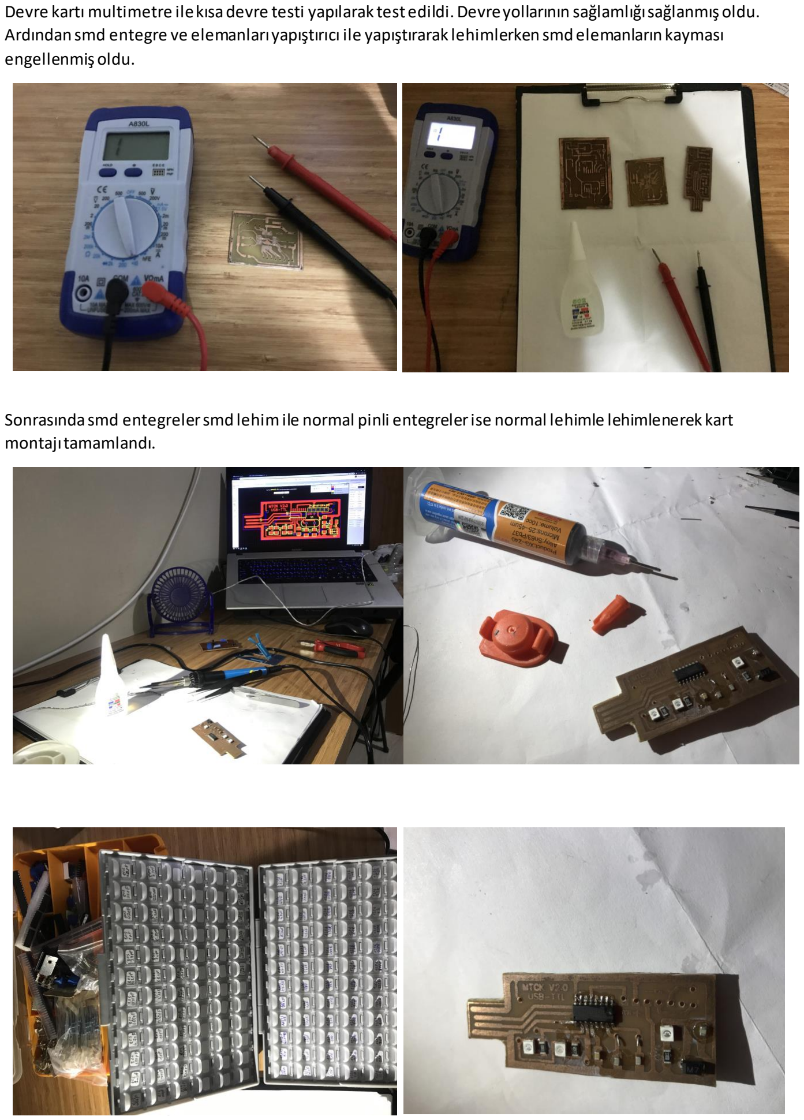
[picture p44: page 2]

Devre kartı multimetre ile kısa devre testi yapılarak test edildi. Devre yollarının sağlamlığı sağlanmış oldu. Ardından smd entegre ve elemanları yapıştırıcı ile yapıştırarak lehimlerken smd elemanların kayması engellenmiş oldu.

Sonrasında smd entegreler smd lehim ile normal pinli entegreler ise normal lehimle lehimlenerek kart montajı tamamlandı.

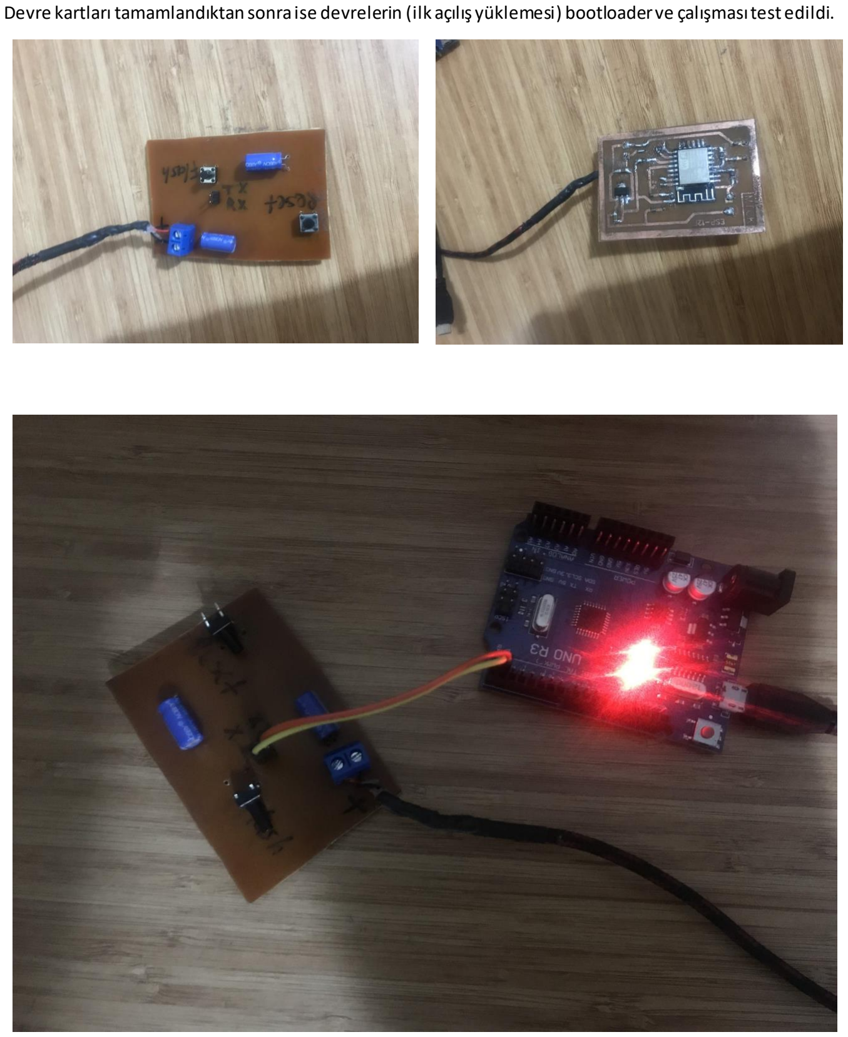
[picture p45: page 3]

Devre kartları tamamlandıktan sonra ise devrelerin (ilk açılış yüklemesi) bootloader ve çalışması test edildi.
