mmerttccolakk/akilli-rgb-led-denetleyici-terminal/c#-bilgisayar/AkilliAmbiyansRGBLED/AkilliAmbiyansRGBLED/Resources/4-lcd-tv-png-image-thumb1.png

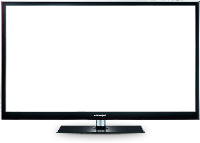
c#-bilgisayar/AkilliAmbiyansRGBLED/AkilliAmbiyansRGBLED/Resources/4-lcd-tv-png-image-thumb1.png
